Technariumas/lazer-maze/lazer-heatsink/lazerio pres.pdf

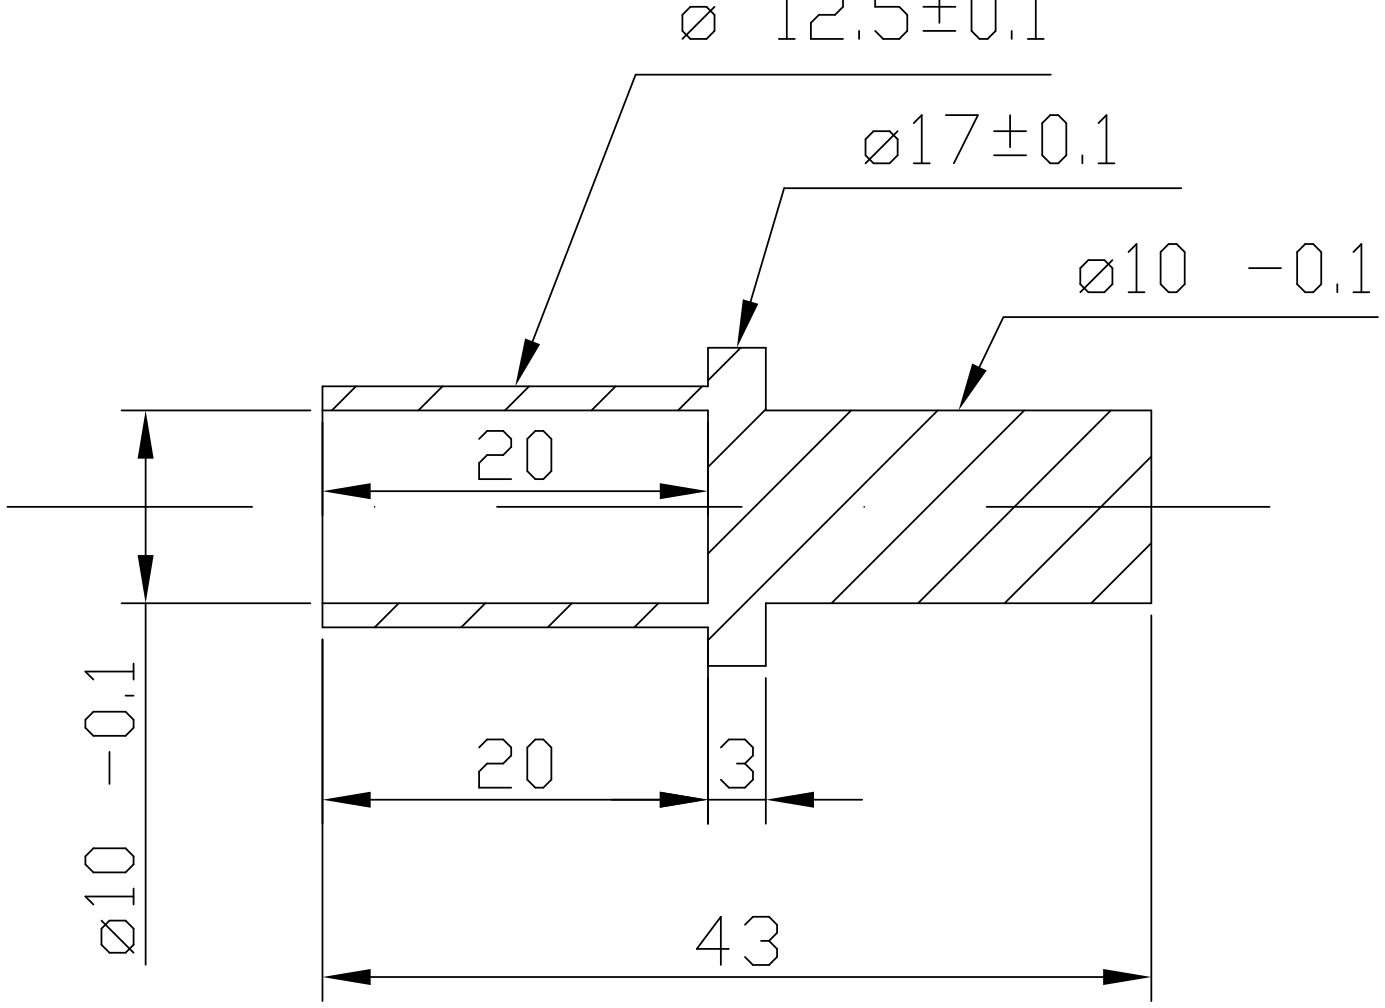
[picture p22: figure]
