Technariumas/lazer-maze/pics/DSC01678.JPG

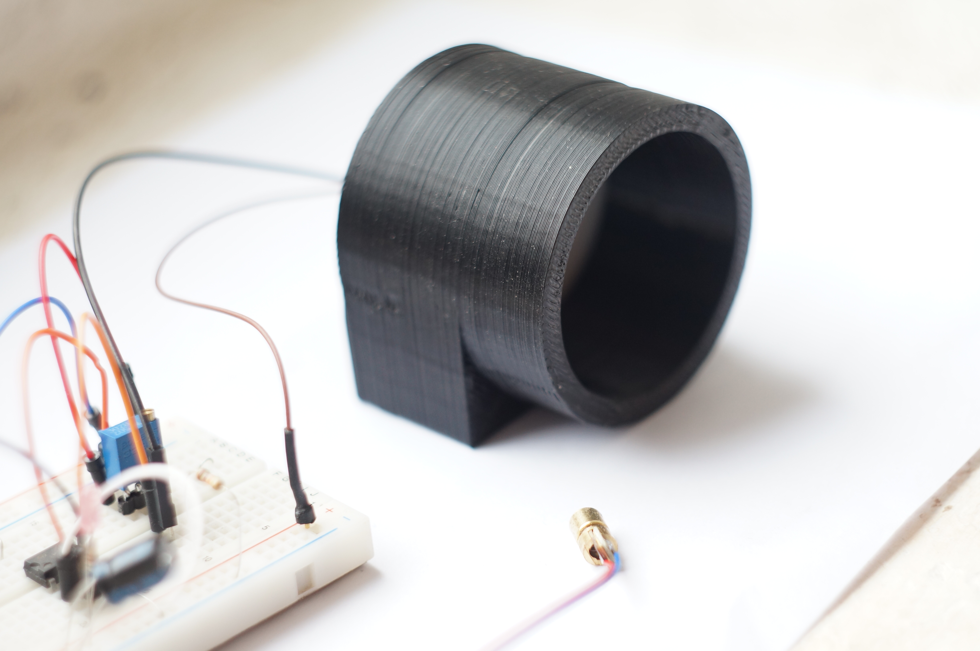
pics/DSC01678.JPG
