Technariumas/lazer-maze/bom.ods

Sheet: Sheet1
Designator | Quantity | Name | Distributor | Distributor ID | Price | Price total | Manufacturer | Manufacturer ID | Comments | Links
B1, B2 | 2 | Li-ion battery | TME | NCR18650PF | 2.75 | 5.5 | PANASONIC | NCR18650PF 3,60V 2,90AH |  | http://www.tme.eu/en/details/ncr18650pf/rechargeable-batteries/panasonic/ncr18650pf-360v-290ah/
DL | 1 | Laser | ebay |  | 3.4 | 3.4 |  |  |  | http://www.ebay.com/itm/331683831675?_trksid=p2057872.m2749.l2649&ssPageName=STRK%3AMEBIDX%3AIT
Q1, Q2, Q3, Q4 | 4 | Phototransistor | Farnell | 1497672 | 0.697 | 2.788 | VISHAY | TEMT6200FX01 |  | http://lt.farnell.com/vishay/temt6200fx01/photodiode-sensor-ambient-light/dp/1497672
TX | 1 | RF transmitter | TME | RFM69W-868S2 | 3.1 | 3.1 | HOPE MICROELECTRONICS | RFM69W-868S2 |  | http://www.tme.eu/en/details/rfm02_433s2/rf-communication-modules/hope-microelectronics/rfm02-433s2/
U3 | 1 | Digital pot | Farnell | 1557424 | 1.22 | 1.22 | MICROCHIP | MCP41100-I/SN
U2 | 1 | Comparator | Farnell | 2342314 | 0.081 | 0.081 | TEXAS INSTRUMENTS | LM293ADR
P3, P4 | 2 | Battery contact | TME | KEYS54 | 0.4445 | 0.889 | KEYSTONE | 54
TH1 | 1 | Polyfuse | Farnell | 1800751 | 0.082 | 0.158 | MULTICOMP | MC33191 |  | http://lt.farnell.com/multicomp/mc33191/fuse-ptc-reset-smd-8v-500ma/dp/1800751
Q5 | 1 | Transistor | Farnell | 9845020 | 0.23 | 0.23 | FAIRCHILD SEMICONDUCTOR | FDV303N
IC1 | 1 | Microcontroller | Farnell | 2396717 | 1.31 | 1.31 | ATMEL | ATTINY441-SSU
U1 | 1 | LDO regulator | Farnell | 1470478 | 0.1992 | 0.1992 | TEXAS INSTRUMENTS | TPS79333DBVR
C2 | 2 | Electrolytic cap | Farnell | 2068653 | 0.154 | 0.308 | KEMET | EDK107M016A9GAA
Q6 | 1 | Transistor | Farnell | 1431297 | 0.107 | 0.107 | ON SEMICONDUCTOR | NTR2101PT1G | Reverse polarity protection and switch
SW1 | 1 | Switch | Farnell | 1201431 | 0.27 | 0.27 | C & K COMPONENTS | OS102011MA1QN1
 |  |  |  |  |  | 0
 |  |  |  |  |  | 0
 |  |  |  |  |  | 0
 |  |  |  |  |  | 0
 |  |  |  |  |  | 0
 |  |  |  |  |  | 0
 |  |  |  |  |  | 0
 |  |  |  |  |  | 0
 |  |  |  |  |  | 0
 |  |  |  |  |  | 0
 |  |  |  |  |  | 0
 |  |  |  |  |  | 0
 |  |  |  |  |  | 0
PCB | 1 |  |  |  | 5 | 5
 |  |  |  |  |  | 24.5602
 |  |  |  |  |  | 491.204

Sheet: Išlaidos
2016-03-29 | 259.21 | TME | Akumuliatoriai ir radijo moduliai
2016-03-30 | 28.54 | Farnell | Elektronikos dalys prototipams
2016-04-13 | 184.55 | Farnell | Elektronikos dalys
2013-04-13 | 101 | Ebay | Heatsinkai lazeriams
 | 573.3
