Technariumas/lazer-maze/mechanics/korpusasV4full.stl

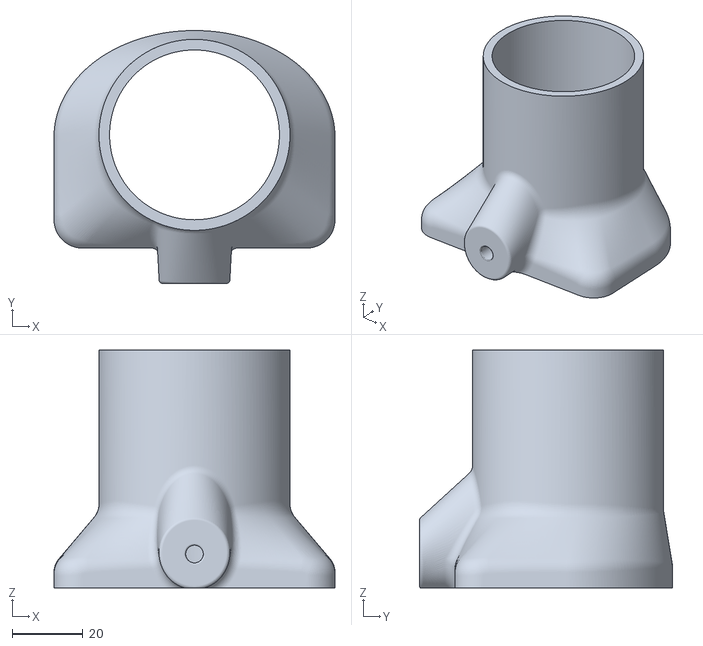
[picture p24: CAD file, 2016-05-18]
mechanics/korpusasV4full.stl
79.4 x 71.5 x 67.2
