Technariumas/lazer-maze/mechanics/tarpineV4full.stl

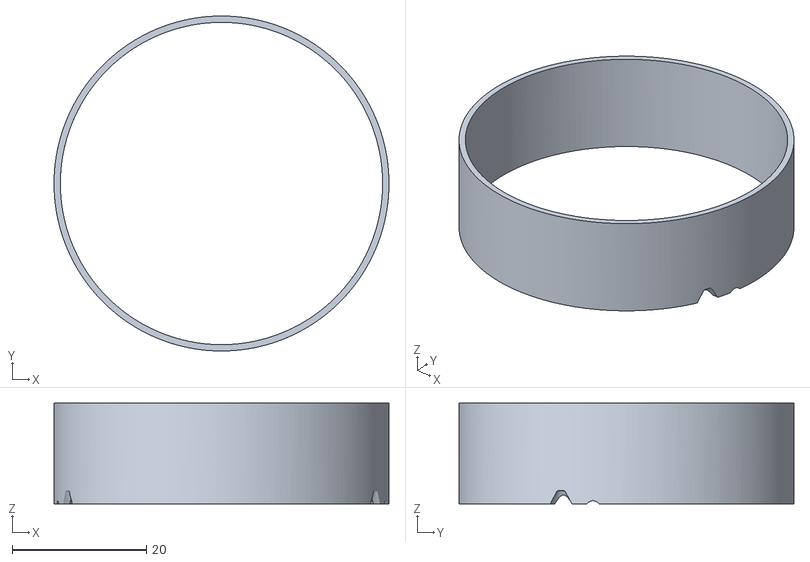
[picture p25: CAD file, 2016-05-18]
mechanics/tarpineV4full.stl
49.9 x 49.9 x 15.0
