Technariumas/lazer-maze/3dprints/ploksteR12kicadgutV22.dxf

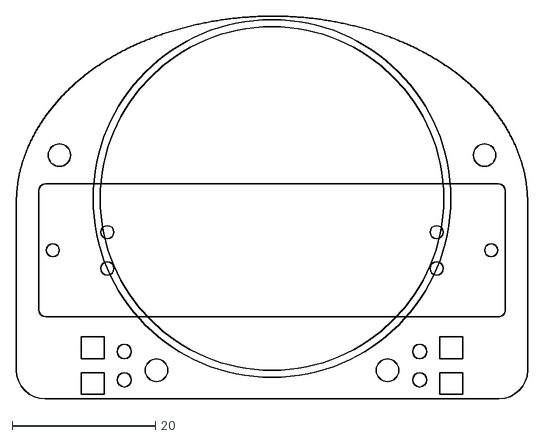
[picture p26: CAD file, 2016-03-29]
3dprints/ploksteR12kicadgutV22.dxf
71.4 x 53.5
