Technariumas/lazer-maze/pics/case2.stl

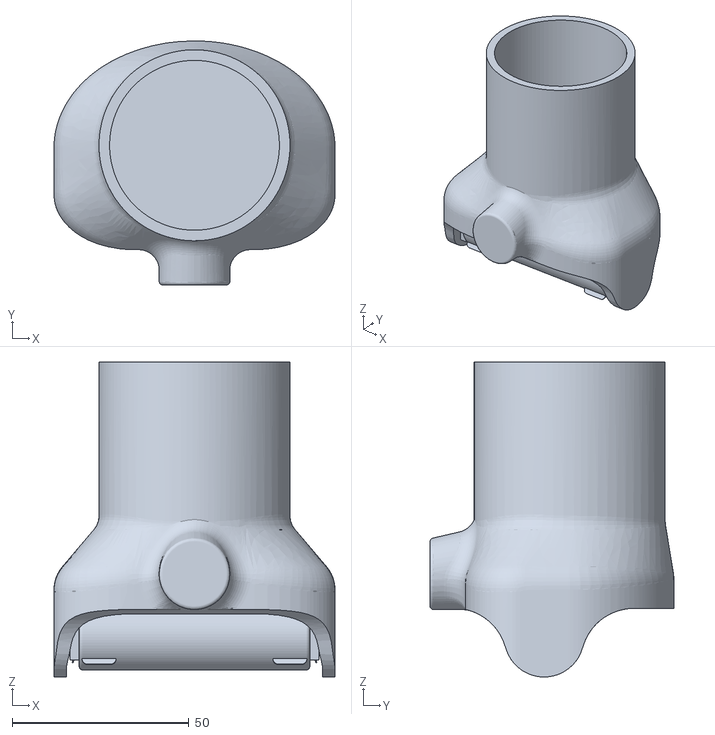
[picture p27: CAD file, 2016-03-25]
pics/case2.stl
79.4 x 69.0 x 89.0
