Technariumas/lazer-maze/3dprints/ploksteR12kicadgut2is_br.dxf

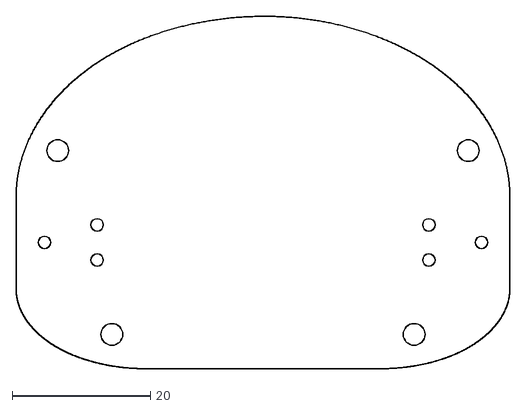
[picture p28: CAD file, 2016-03-25]
3dprints/ploksteR12kicadgut2is_br.dxf
71.4 x 51.0
