Technariumas/lazer-maze/3dprints/plokste.dxf

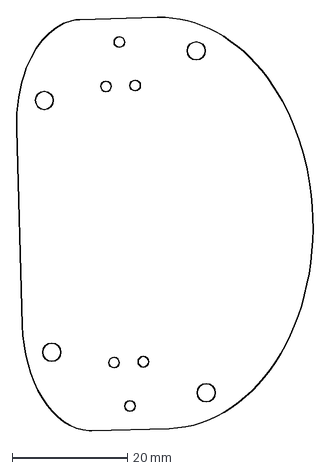
[picture p29: CAD file, 2016-03-25]
3dprints/plokste.dxf
52.6 x 72.0 mm
