Technariumas/lazer-maze/3dprints/test-receiver.stl

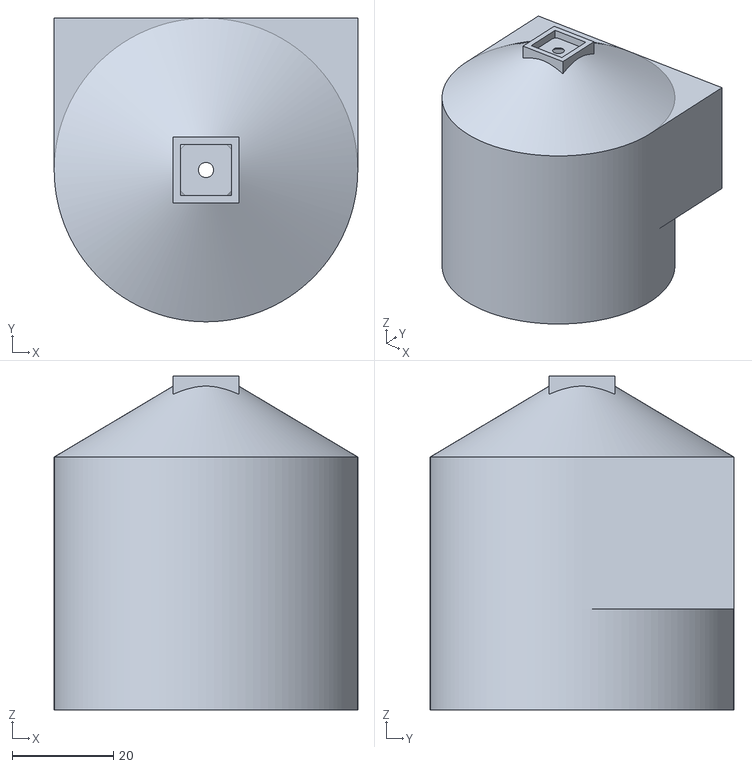
[picture p30: CAD file, 2016-03-04]
3dprints/test-receiver.stl
60.0 x 60.0 x 66.0
