Technariumas/lazer-maze/detector/18650.IGS

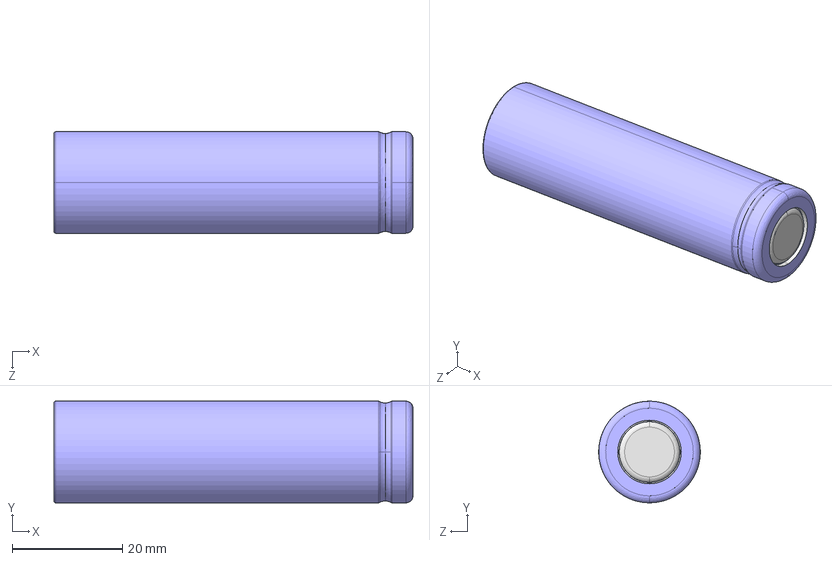
[picture p31: CAD file, 2016-03-26]
detector/18650.IGS
65.0 x 18.4 x 18.4 mm
