Technariumas/lazer-maze/3dprints/ploksteR12kicadgutV2.dxf

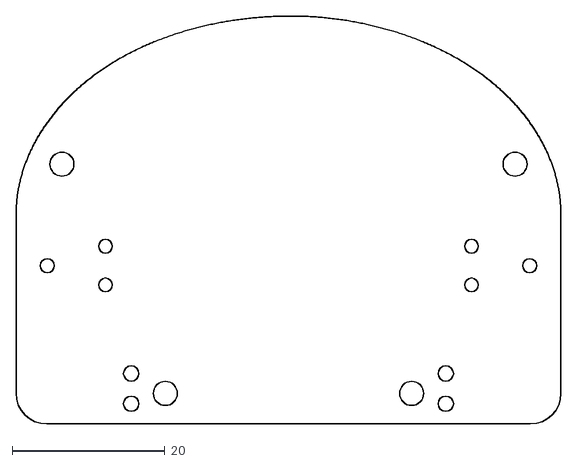
[picture p32: CAD file, 2016-03-26, an earlier design]
3dprints/ploksteR12kicadgutV2.dxf
71.4 x 53.5
