Technariumas/lazer-maze/(list of files, cad)

Other CAD files:
lazer-heatsink/lazerio hytsinkas.dwg
3dprints/imtuvas.stp
