Technariumas/lazer-maze/lazer-heatsink/Lazerio hyts.pdf

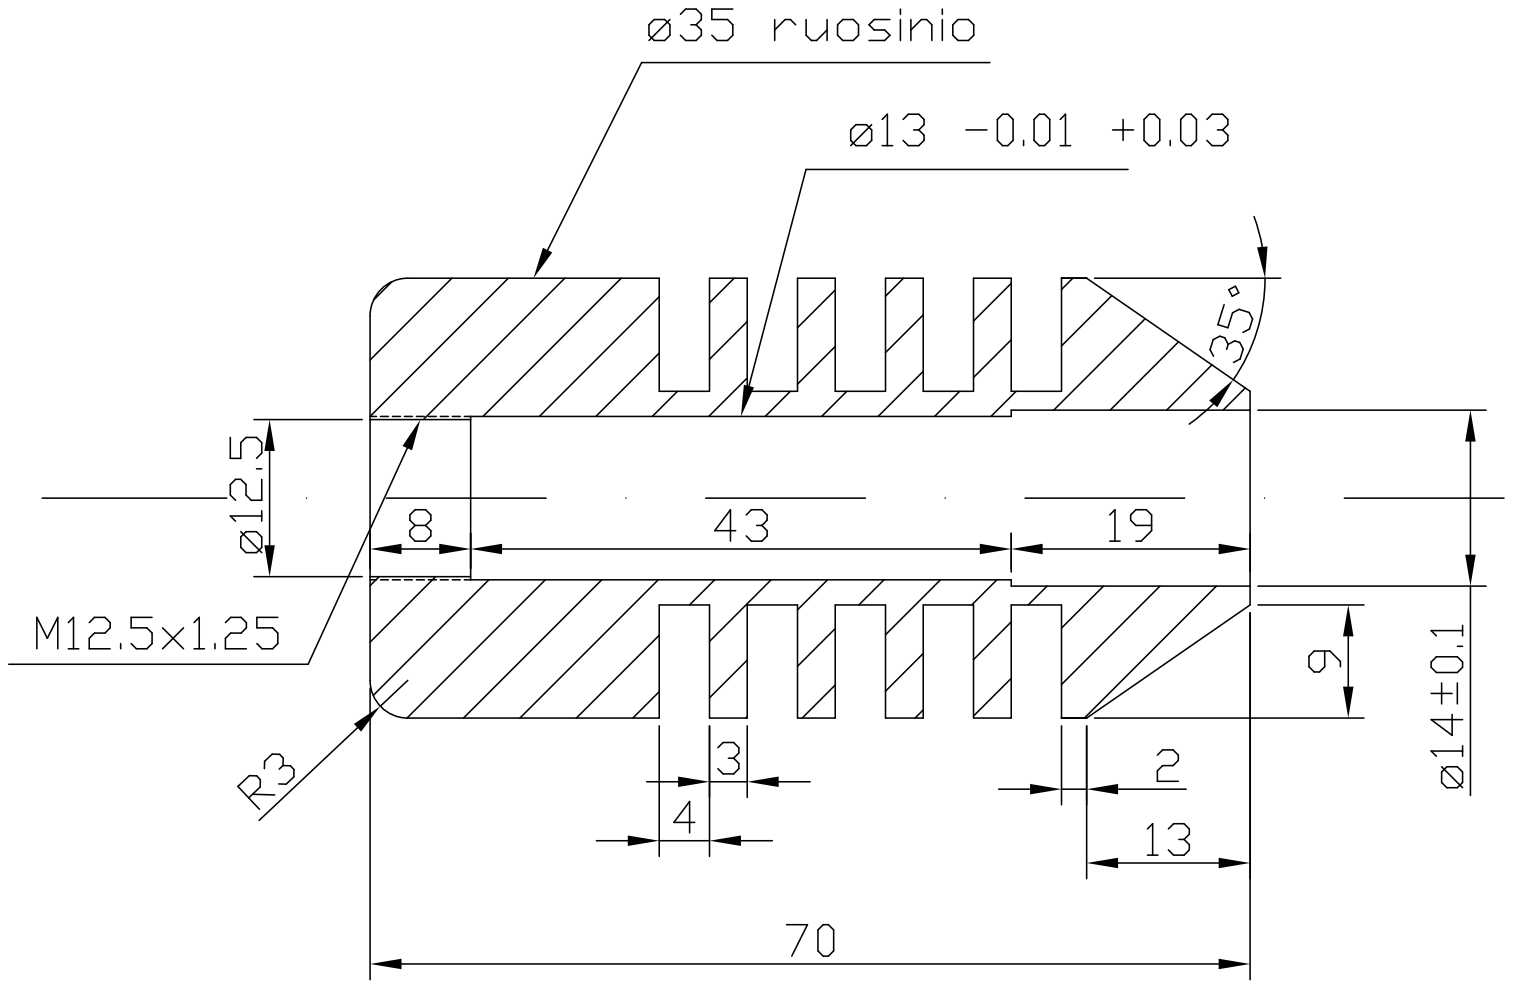
[picture p33: page 1]
