Technariumas/lazer-maze/doc/KEYS54(1).pdf

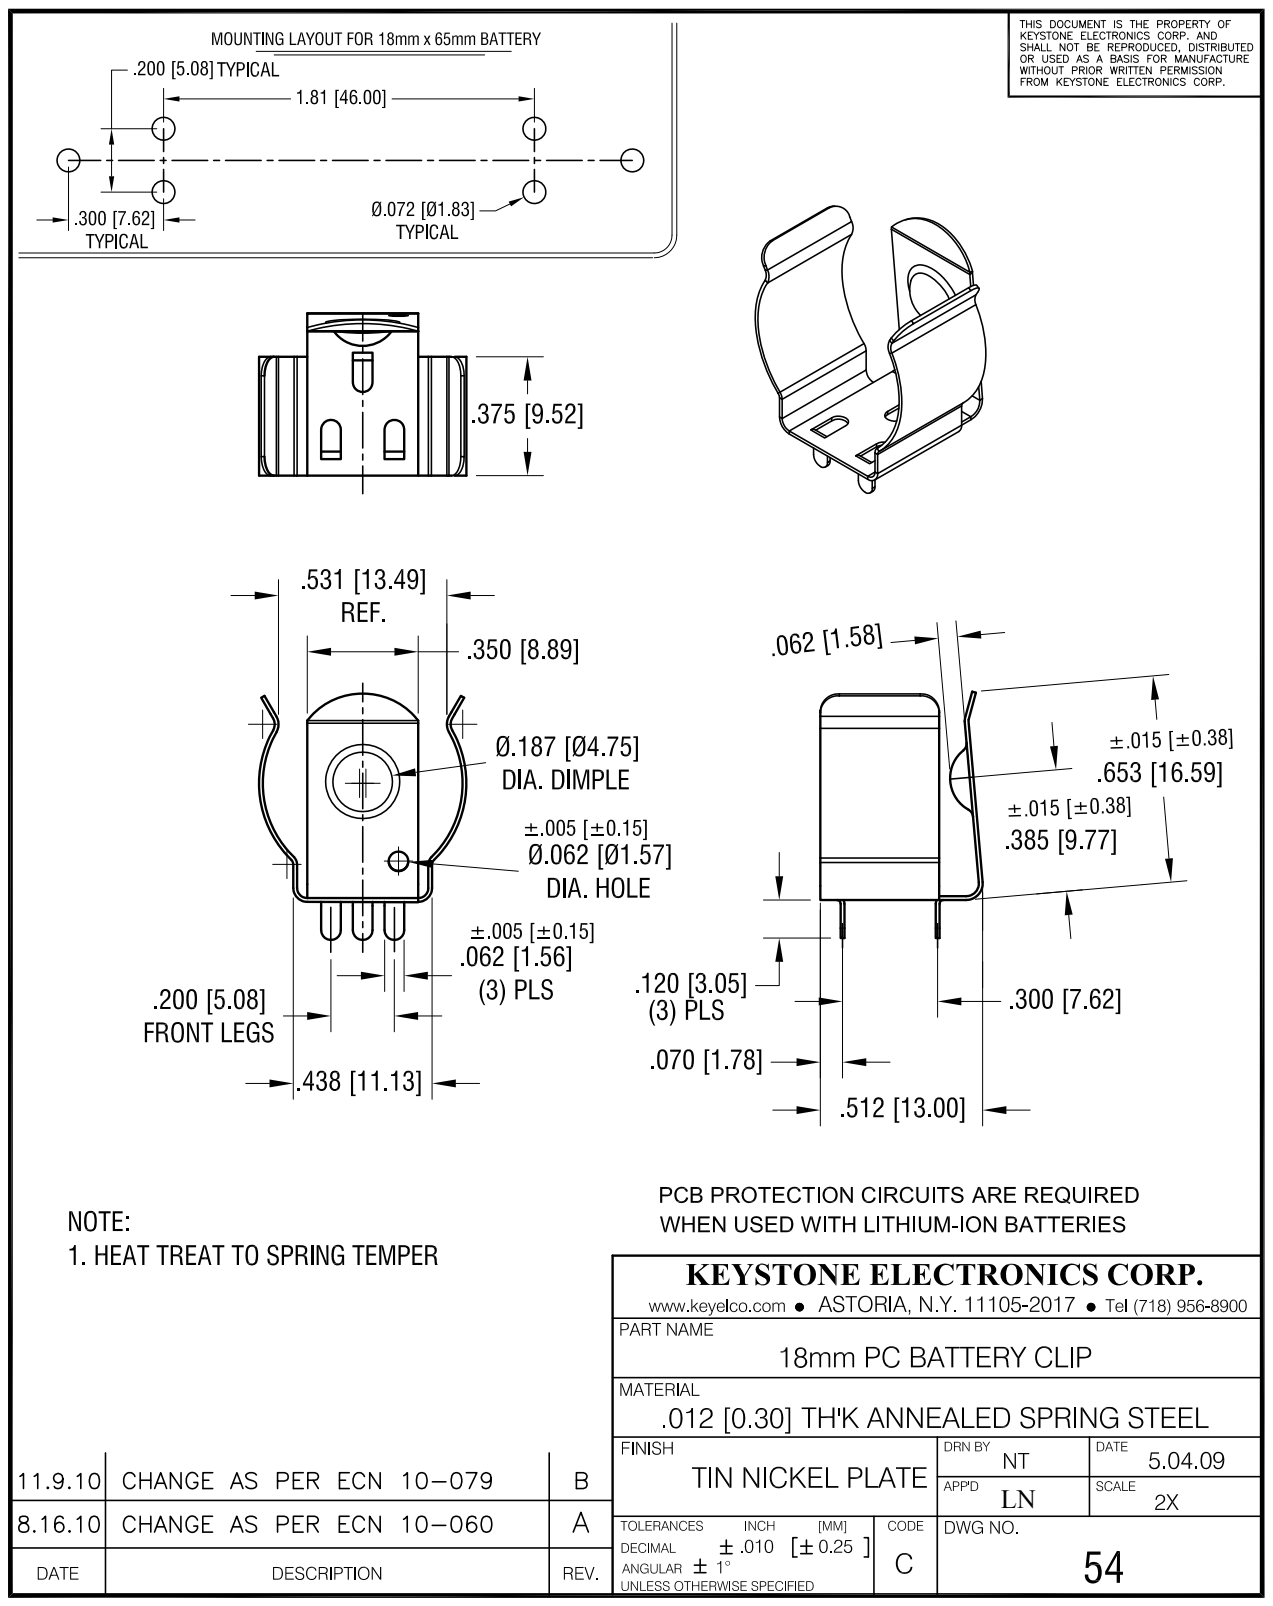
[picture p34: page 1]
