Technariumas/lazer-maze/gysteresis.asc

R1: res; 24k
R2: res; 76k
R3: res; 10k
R4: res; 5000k
R5: res; 512k
U1: LM339
V1: voltage; 5
V2: voltage; SINE(0.2 0.03 1)
Named nets: 0
.tran 3
