Technariumas/lazer-maze/detector/detector.kicad_pcb

## KiCad design detector/detector.kicad_pcb (2016-04-17)

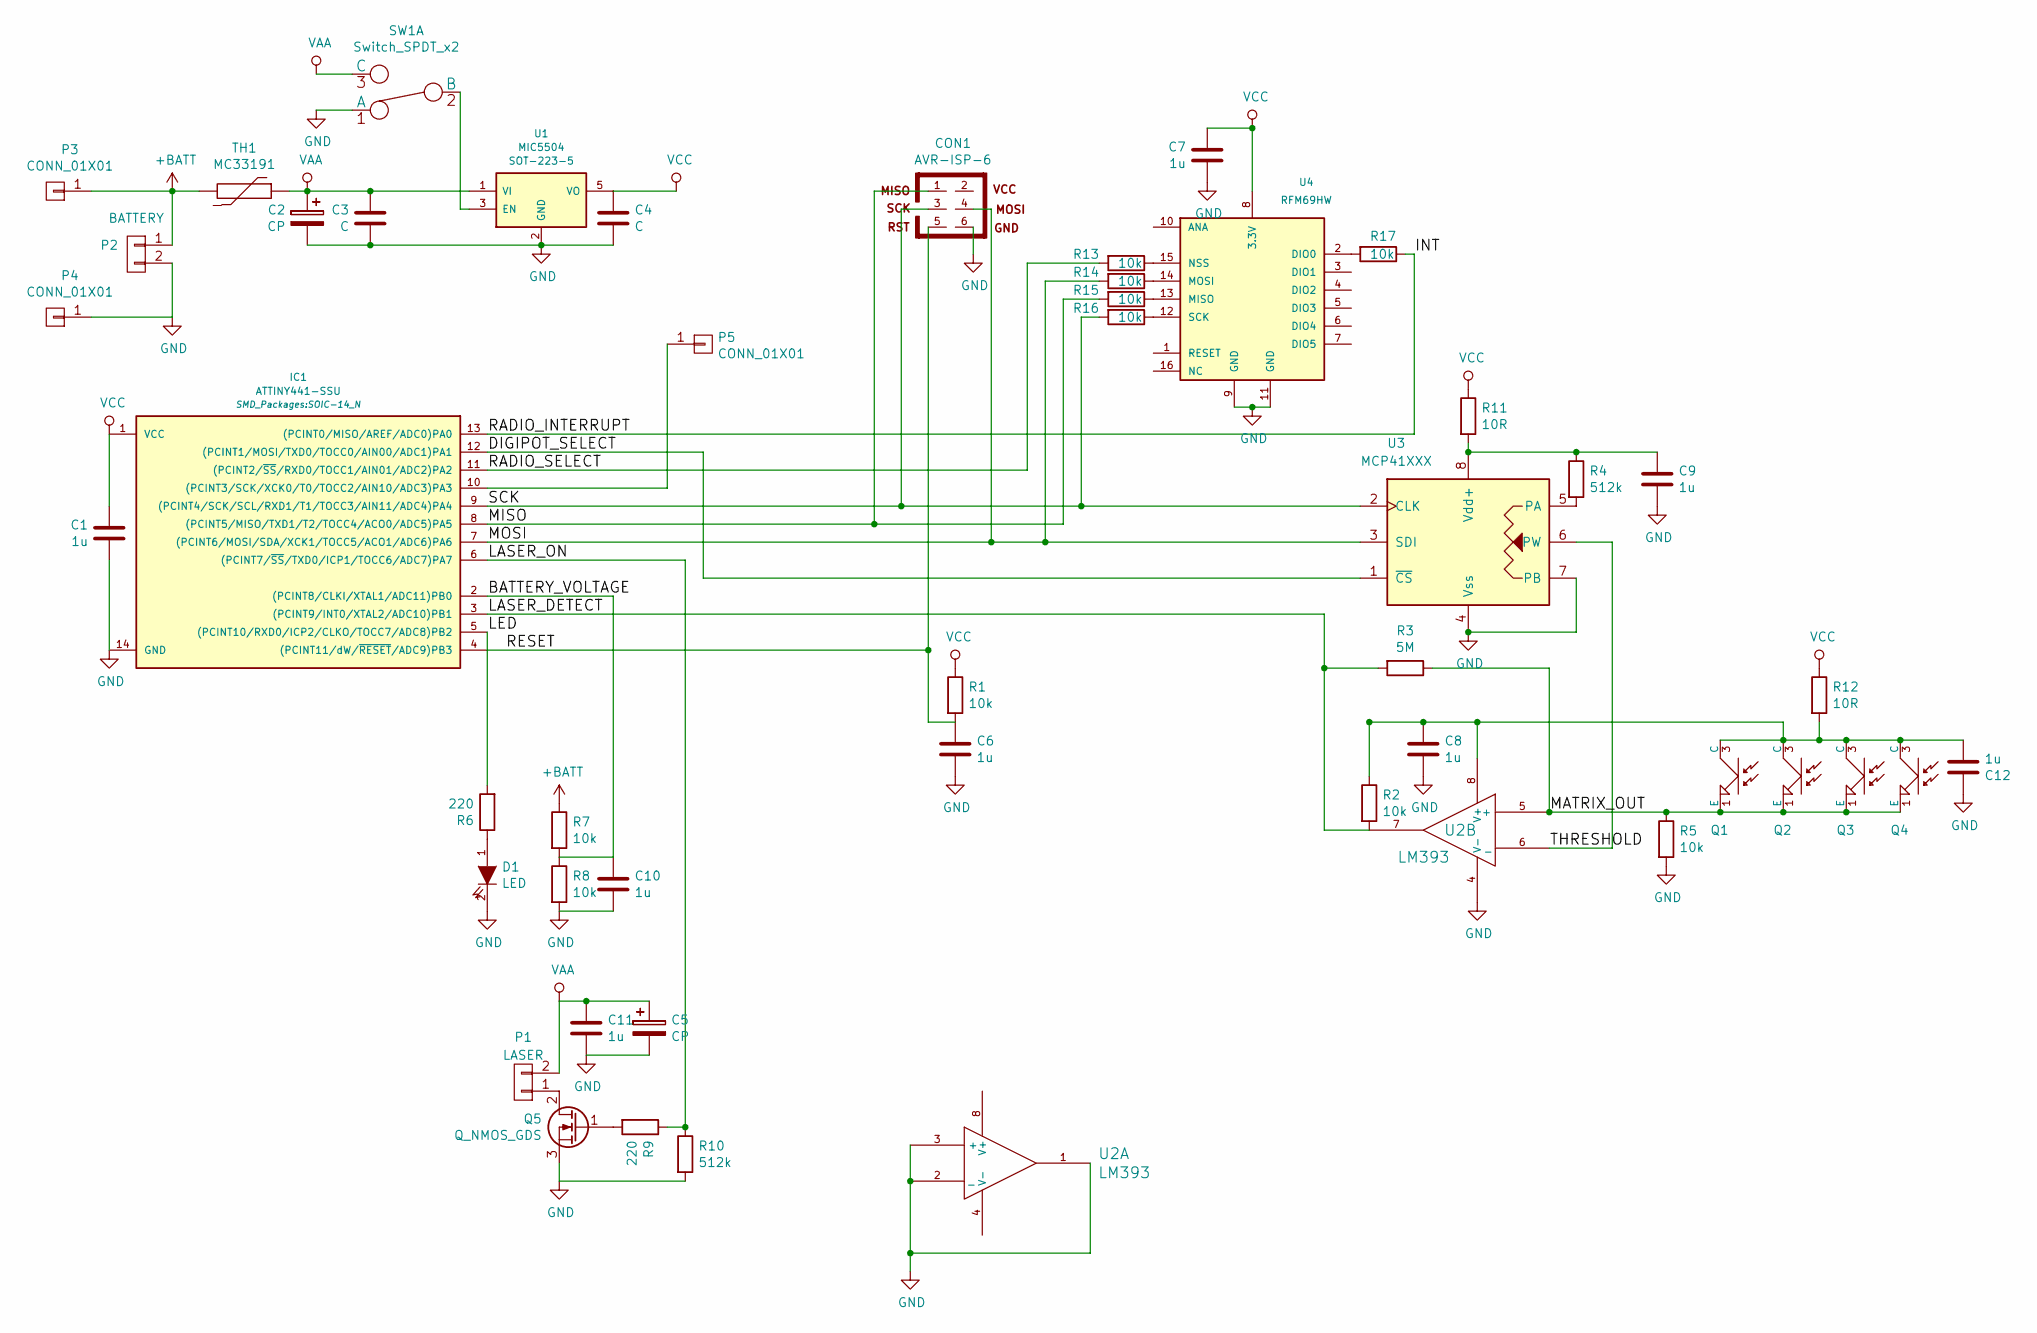
[picture p35: schematic detector.sch, Laser maze detector]

Parts:
C1, C6, C7, C8, C9, C10, C11, C12: 1u; C_0603_HandSoldering
C2, C5: CP; c_elec_6.3x5.3; PartNo EDK107M016A9GAA
C3, C4: C; C_0603_HandSoldering
CON1: AVR-ISP-6; Pin_Header_Angled_2x03
D1: LED; Led_0603; PartNo ?
IC1: ATTINY441-SSU; SOIC-14_N; PartNo ?
P1: LASER; Pin_Header_Straight_1x02_Pitch3.96mm_Friction_Lock; PartNo ?
P2: BATTERY; Pin_Header_Straight_1x02_Pitch3.96mm_Friction_Lock; PartNo ?
P3, P4: CONN_01X01; Pin_Header_Straight_1x01; PartNo ?
P5: CONN_01X01; pin_socket_1; PartNo ?
Q1, Q2, Q3, Q4: OPTO_NPN; Led_0805; PartNo ?
Q5: Q_NMOS_GDS; SOT-23_Handsoldering; PartNo FDV303N
R1, R2, R5, R7, R8, R13, R14, R15, R16, R17: 10k; R_0603_HandSoldering
R3: 5M; R_0603_HandSoldering
R4, R10: 512k; R_0603_HandSoldering
R6, R9: 220; R_0603_HandSoldering
R11, R12: 10R; R_0603_HandSoldering
SW1: Switch_SPDT_x2
TH1: MC33191; Fuse_SMD1206_HandSoldering; PartNo MC33191
U1: MIC5504; SOT-223-5; PartNo MIC5504-3.3YM5-TR
U2: LM393; SOIC-8_3.9x4.9mm_Pitch1.27mm; PartNo ?
U3: MCP41XXX; SOIC-8_3.9x4.9mm_Pitch1.27mm; PartNo MCP41100-I/SN
U4: RFM69HW; RFM69HW_SMD_ThroughHole_Handsoldering

Connections:
+BATT: P2.1, P3.1, R7.1, TH1.2
/BATTERY_VOLTAGE: C10.1, IC1.2 ((PCINT8/CLKI/XTAL1/ADC11)PB0), R7.2, R8.1
/DIGIPOT_SELECT: IC1.12 ((PCINT1/MOSI/TXD0/TOCC0/AIN00/ADC1)PA1), U3.1 (~CS~)
/INT: IC1.13 ((PCINT0/MISO/AREF/ADC0)PA0), R17.1
/LASER_DETECT: IC1.3 ((PCINT9/INT0/XTAL2/ADC10)PB1), R2.2, R3.2, U2.7
/LASER_ON: IC1.6 ((PCINT7/~SS~/TXD0/ICP1/TOCC6/ADC7)PA7), R9.1, R10.1
/LED: IC1.5 ((PCINT10/RXD0/ICP2/CLKO/TOCC7/ADC8)PB2), R6.2
/MATRIX_OUT: Q1.1 (E), Q2.1 (E), Q3.1 (E), Q4.1 (E), R3.1, R5.1, U2.5 (+)
/MISO: CON1.1, IC1.8 ((PCINT5/MISO/TXD1/T2/TOCC4/ACO0/ADC5)PA5), R15.2
/MOSI: CON1.4, IC1.7 ((PCINT6/MOSI/SDA/XCK1/TOCC5/ACO1/ADC6)P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), R14.2, U3.3 (SDI)
/RADIO_SELECT: IC1.11 ((PCINT2/~SS~/RXD0/TOCC1/AIN01/ADC2)PA2), R13.2
/RESET: C6.1, CON1.5, IC1.4 ((PCINT11/dW/~RESET~/ADC9)PB3), R1.2
/SCK: CON1.3, IC1.9 ((PCINT4/SCK/SCL/RXD1/T1/TOCC3/AIN11/ADC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), R16.2, U3.2 (CLK)
/THRESHOLD: U2.6 (_), U3.6 (PW)
GND: C1.2, C2.2, C3.2, C4.2, C5.2, C6.2, C7.2, C8.2, C9.2, C10.2, C11.2, C12.1, CON1.6, D1.2 (K), IC1.14 (GND), P2.2, P4.1, Q5.3 (S), R5.2, R8.2, R10.2, SW1.1 (A), U1.2 (GND), U2.1, U2.2 (_), U2.3 (+), U2.4 (V-), U3.4 (Vss), U3.7 (PB), U4.9 (GND), U4.11 (GND); also elsewhere on the board
unnamed: C9.1, R4.1, R11.2, U3.8 (Vdd+)
unnamed: C8.1, C12.2, Q1.3 (C), Q2.3 (C), Q3.3 (C), Q4.3 (C), R2.1, R12.2, U2.8 (V+)
unnamed: D1.1 (A), R6.1
unnamed: IC1.10 ((PCINT3/SCK/XCK0/T0/TOCC2/AIN10/ADC3)PA3), P5.1
unnamed: P1.1, Q5.2 (D)
unnamed: Q5.1 (G), R9.2
unnamed: R4.2, U3.5 (PA)
unnamed: R13.1, U4.15 (NSS)
unnamed: R14.1, U4.14 (MOSI)
unnamed: R15.1, U4.13 (MISO)
unnamed: R16.1, U4.12 (SCK)
unnamed: R17.2, U4.2 (DIO0)
unnamed: SW1.2 (B), U1.3 (EN)
VAA: C2.1, C3.1, C5.1, C11.1, P1.2, SW1.3 (C), TH1.1, U1.1 (VI)
VCC: C1.1, C4.1, C7.1, IC1.1 (VCC), R1.1, R11.1, R12.1, U1.5 (VO), U4.8 (3.3V)

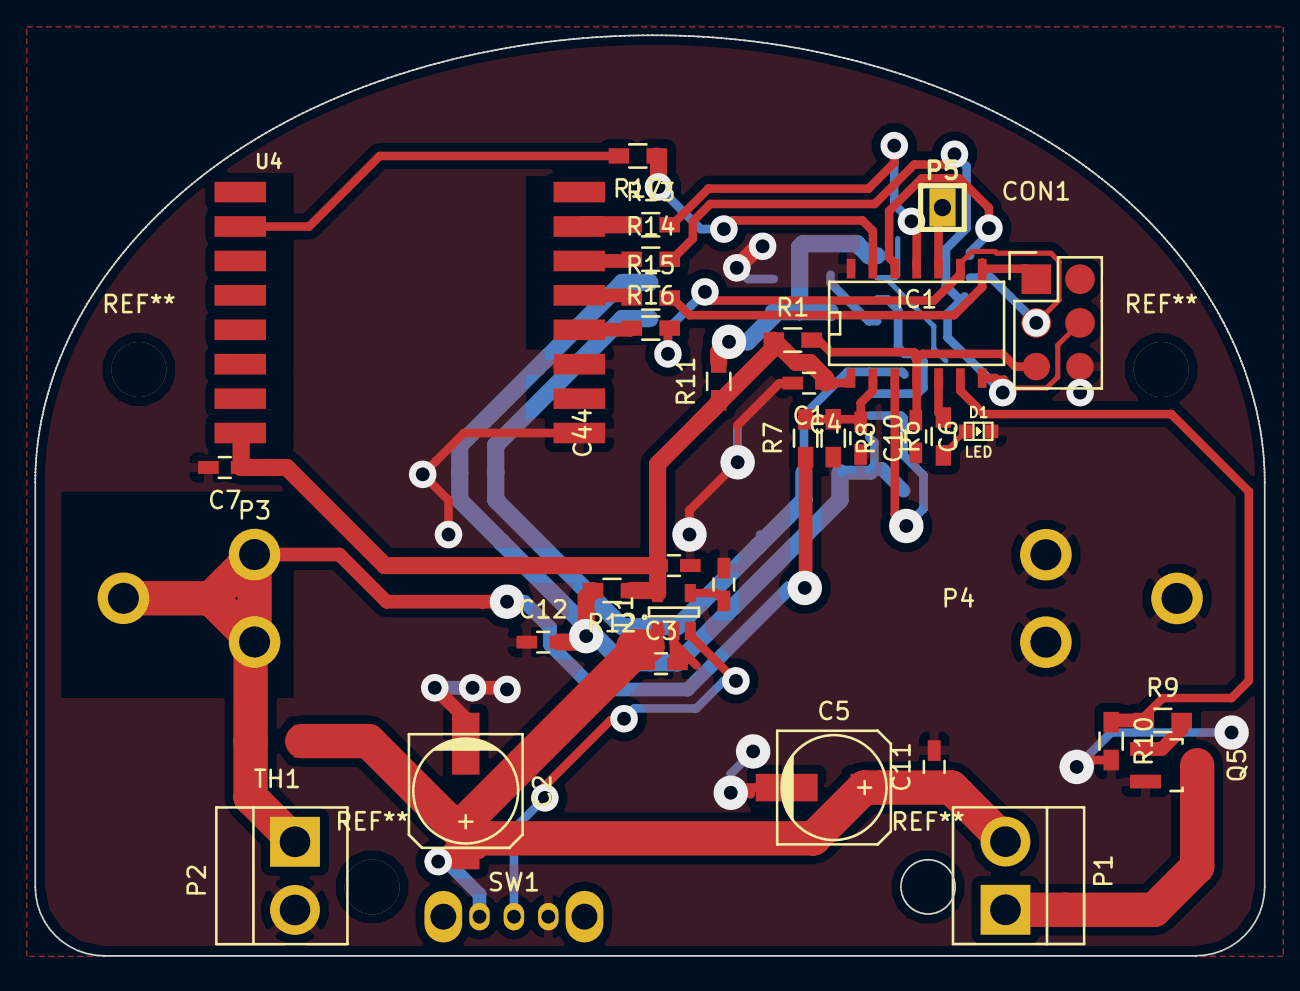
[picture p36: board detector.kicad_pcb from above]

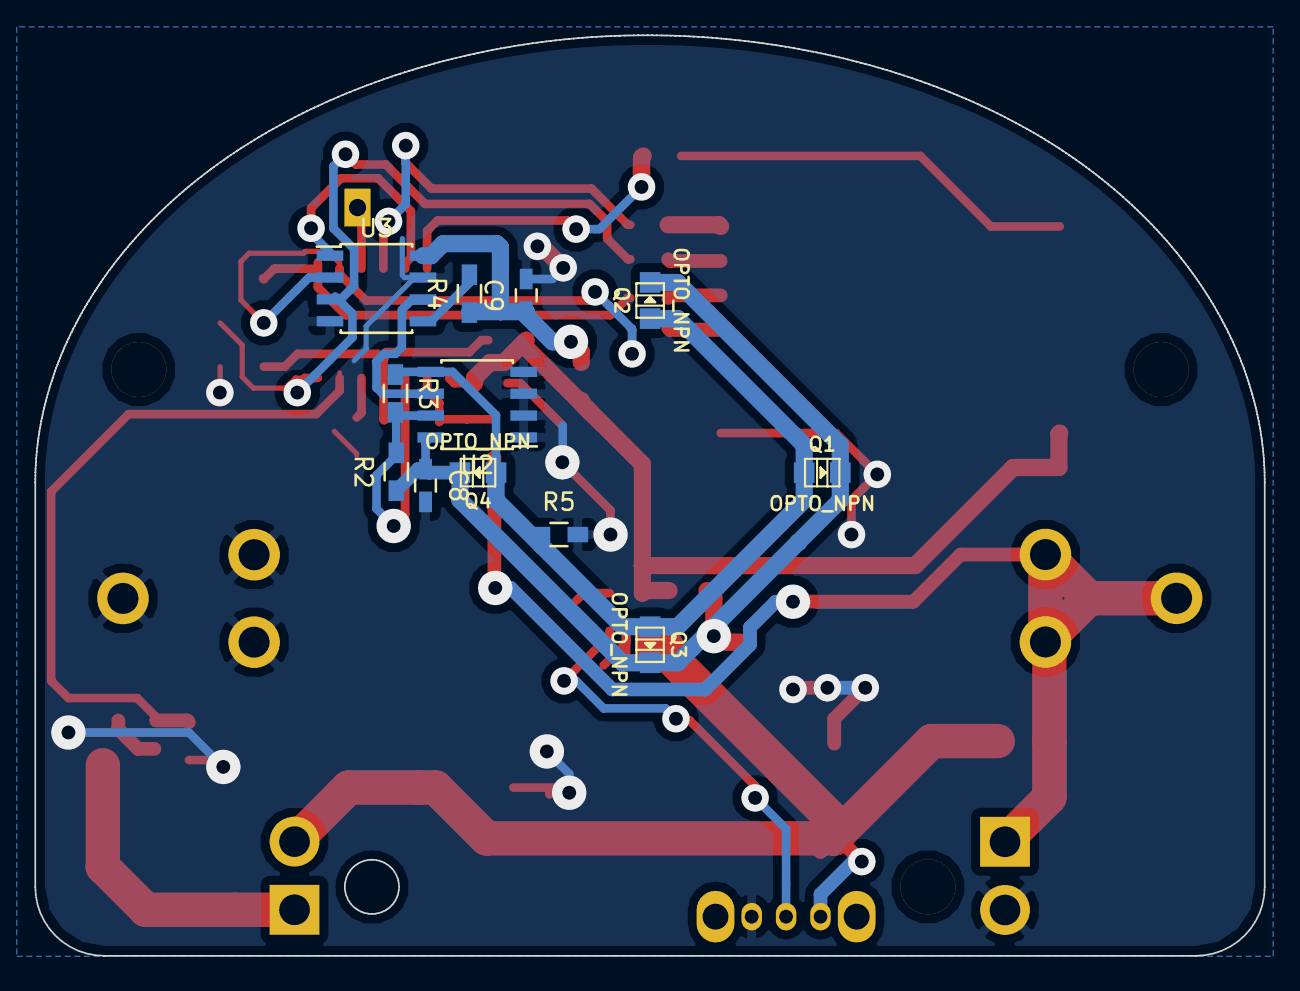
[picture p37: board detector.kicad_pcb from below]

Board: 2 copper layers, 71.4 x 53.5 mm, 49 parts (12 on the bottom side), 30 nets.

Other parts of the board:
C44: C; C_0603_HandSoldering

Their connections:
GND: C44.2; also elsewhere on the board
