Technariumas/lazer-maze/src/timer.c

#include <avr/io.h>
#include <avr/interrupt.h>
#include "timer.h"

#define clockCyclesPerMicrosecond() ( F_CPU / 1000000L )
#define clockCyclesToMicroseconds(a) ( (a) / clockCyclesPerMicrosecond() )
#define microsecondsToClockCycles(a) ( (a) * clockCyclesPerMicrosecond() )
#define MICROSECONDS_PER_TIMER0_OVERFLOW (clockCyclesToMicroseconds(64 * 256))
#define MILLIS_INC (MICROSECONDS_PER_TIMER0_OVERFLOW / 1000)
#define FRACT_INC ((MICROSECONDS_PER_TIMER0_OVERFLOW % 1000) >> 3)
#define FRACT_MAX (1000 >> 3)
extern "C" {

volatile unsigned long timer0_overflow_count = 0;
volatile unsigned long timer0_millis = 0;
static unsigned char timer0_fract = 0;


ISR(TIMER0_OVF_vect) {
    // copy these to local variables so they can be stored in registers
    // (volatile variables must be read from memory on every access)
    unsigned long m = timer0_millis;
    unsigned char f = timer0_fract;

    m += MILLIS_INC;
    f += FRACT_INC;
    if (f >= FRACT_MAX) {
            f -= FRACT_MAX;
            m += 1;
    }

    timer0_fract = f;
    timer0_millis = m;
    timer0_overflow_count++;
}

unsigned long millis() {
    unsigned long m;
    uint8_t oldSREG = SREG;

    // disable interrupts while we read timer0_millis or we might get an
    // inconsistent value (e.g. in the middle of a write to timer0_millis)
    cli();
    m = timer0_millis;
    SREG = oldSREG;

    return m;
}

unsigned long micros() {
        unsigned long m;
        uint8_t oldSREG = SREG, t;
        
        cli();
        m = timer0_overflow_count;
        t = TCNT0;
        if ((TIFR0 & _BV(TOV0)) && (t < 255))
                m++;
        SREG = oldSREG;

        return ((m << 8) + t) * (64 / clockCyclesPerMicrosecond());
}


void delay(unsigned long ms) {
    uint16_t start = (uint16_t)micros();

    while (ms > 0) {
            if (((uint16_t)micros() - start) >= 1000) {
                    ms--;
                    start += 1000;
            }
    }
}

}
