Technariumas/lazer-maze/(commit log)

2016-03-04 Initial commit, add the first 3dprints, bom, etc
    [bom.ods, test-receiver.scad, test-receiver.stl]
2016-03-05 Add initial schematics, add simulation of hysteresis
    [receiver.kicad_pcb, receiver.sch]
2016-03-05 Add comparator to the BOM
    [bom.ods]
2016-03-11 Add more details, add a chapter on lasers
2016-03-11 Add footprints, prepare for PCB routing
    [receiver.sch]
2016-03-11 More specific BOM
    [bom.ods]
2016-03-11 Add ebay laser pic
2016-03-14 Add a comparator schematics
2016-03-14 Add rationale about the design change and laser analysis results
2016-03-15 Add case pic
2016-03-25 Schematics changes: change RF module to RFM69, add onboard phototransistors, add a switch for laser, put programming header on proper pins, add PTC to the power supply, add voltage measurement divide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
    [receiver.kicad_pcb, receiver.sch]
2016-03-25 Label all nets
    [receiver.sch]
2016-03-25 Add new 3d files
    [imtuvas.stp, plokste.dxf, ploksteR12kicadgut2is_br.dxf]
2016-03-25 Play around with github and stl files
    [case2.stl]
2016-03-26 Source the components, fill the bom, add battery connectors, remove electrolytic from regulator output, put it to the laser
    [bom.ods, receiver.sch]
2016-03-26 Change comparator to SO8 package. Add I2C pullups.
    [receiver.sch]
2016-03-26 New PCB outline. Add 3D models to PCB. Start routing
    [18650.IGS, ploksteR12kicadgutV2.dxf, receiver.kicad_pcb]
2016-03-26 Add a proper symbol for LDO
    [receiver.kicad_pcb, receiver.sch]
2016-03-29 Add new outline dxf
    [ploksteR12kicadgutV22.dxf]
2016-03-29 Change digipot to event more expensive but easy to solder SO8 SPI based one
    [bom.ods, receiver.kicad_pcb, receiver.sch]
2016-03-29 Put LED to place, connect the laser on line
    [receiver.kicad_pcb]
2016-03-30 The first version of the board sent to manufacturing
    [bom.ods, receiver.kicad_pcb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]
2016-03-30 Add pics of pcb render and 3d-printed case
2016-04-10 Swap comparator inputs so that we could implement MCU wakeup on INT0 low level
    [receiver.sch]
2016-04-10 Swap comparator pins on PCB, move R5 so that ground connection is shorter
    [receiver.kicad_pcb]
2016-04-15 REV2 of the board
    [receiver.kicad_pcb, receiver.sch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]
2016-04-15 Put R3 to the right place - as a hysteresis resistor
    [receiver.sch]
2016-04-15 Add connections to the switch on the bottom side
    [receiver.kicad_pcb]
2016-04-17 Add scope screenshots of different regulator load regulation performance
2016-04-17 Fix 3d model paths
    [receiver.kicad_pcb]
2016-04-17 Folder rename
    [18650.IGS, receiver.kicad_pcb, receiver.sch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]
2016-04-17 Change the LDO to TI one
    [bom.ods]
2016-04-17 Add documentation about LDO selection, make shematics A3
    [detector.sch]
2016-04-28 Added files via upload
    lazer module heatsink-case and module press-in tool blueprints, for turning from aluminum, no holder attachment surface yet
    [lazerio hytsinkas.dwg]
2016-05-01 Add final heatsink blueprint
    [lazerio hytsinkas.dwg]
2016-05-18 Add STL files for case
    [korpusasV4full.stl, tarpineV4full.stl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]
2016-05-25 Add all the functionality at one go: commands to turn on/off the laser, report status, calibration value
2016-05-25 Something has moved, but probably nothing.
    [detector-B.Cu.gbr, detector-Edge.Cuts.gbr, detector-F.Cu.gbr, detector.drl]
2016-06-07 Add a paragraph about laser heatsinks
2016-06-07 Add PCB pictures
2016-06-07 Add laser fixture clamps
2016-06-07 Add the last case pictures
2016-06-07 Add some text about the case design
2016-07-18 Add auxilary input, wait for laser to become visible after trip
2016-07-18 Send also a laser seen message
