Technariumas/lazer-maze/(notices)

Notices in the files:
src/RFM69.cpp:
Copyright Felix Rusu (2014), felix@lowpowerlab.com
Public License as published by the Free Software
Public License along with this program.
